luziato/soccer-18-19/elettronica/dxf/Phoenix.dxf

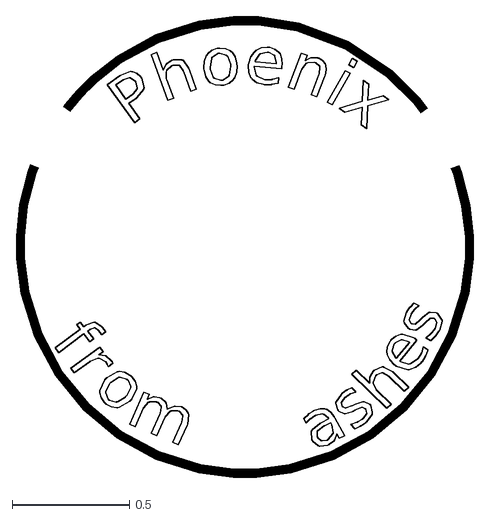
[picture p1: CAD file, 2019-02-13]
elettronica/dxf/Phoenix.dxf
1.95 x 1.97
