luziato/soccer-18-19/elettronica/immagini/vector/Phoenix.dxf

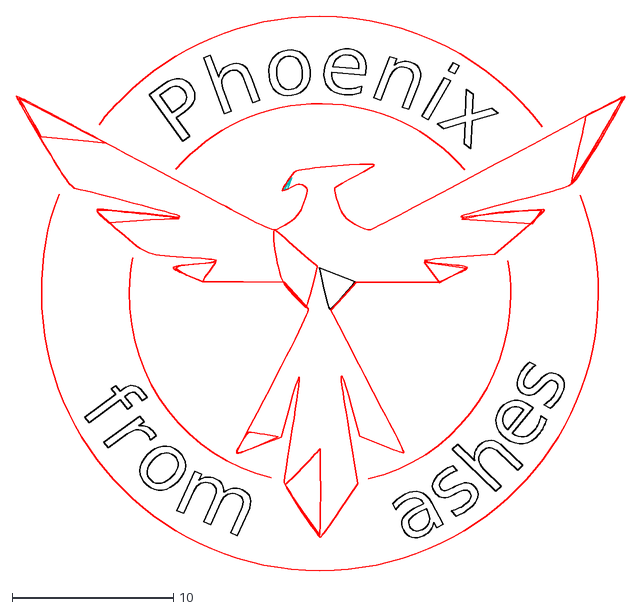
[picture p2: CAD file, 2019-02-13]
elettronica/immagini/vector/Phoenix.dxf
37.9 x 34.4
