luziato/soccer-18-19/elettronica/dxf/line sensor.dxf

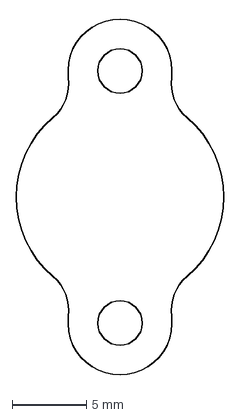
[picture p3: CAD file, 2019-02-13]
elettronica/dxf/line sensor.dxf
14.0 x 24.3 mm
