luziato/soccer-18-19/elettronica/testo.txt

da INSERIRE NELLO SCHEMATICO

-connettore per la batteria
-connettore per la pixi
-connettori pin femmina per circuito i4c
-swithc alimentazione
-swithc alimentazione motori
