luziato/soccer-18-19/elettronica/sensori di liena.brd

## EAGLE design elettronica/sensori di liena.brd (2019-02-13)

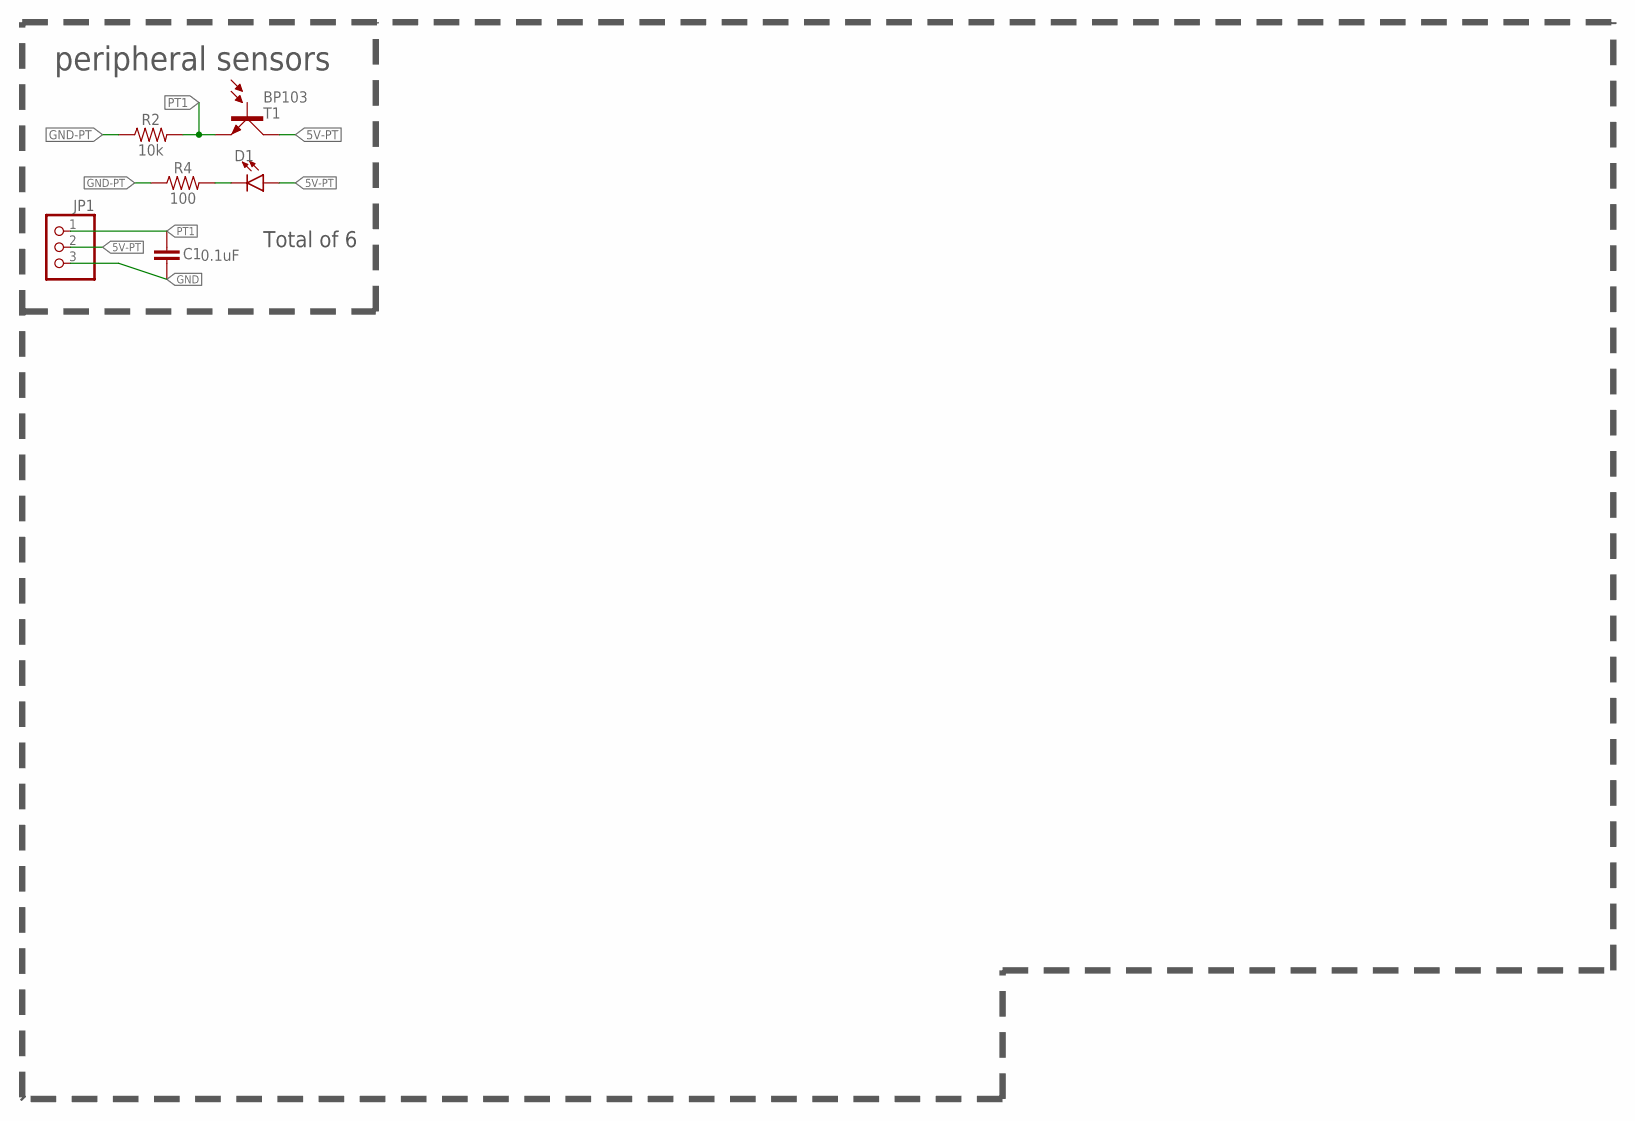
[picture p4: schematic sensori di liena.sch]

Parts:
C1: 0.1uF; CAP-PTH-SMALL-KIT
D1: LED3MM; LED_3MM
JP1: PINHD-1X3; 1X03
R2: 10k; 0603
R4: 100; 0603
T1: BP103

Connections:
5V-PT: D1.A, JP1.2, T1.C
GND: C1.2, JP1.3
GND-PT: R2.1, R4.1
unnamed: D1.K (C), R4.2
PT1: C1.1, JP1.1, R2.2, T1.E

Notes on the sheet:
peripheral sensors
Total of 6

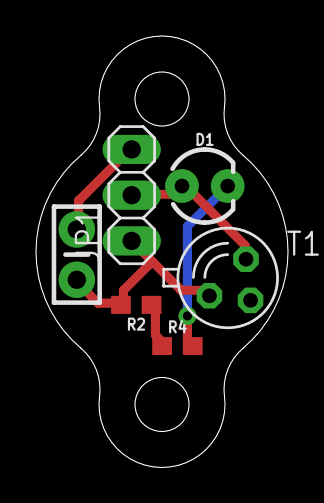
[picture p5: board sensori di liena.brd from above]

Board: 2 copper layers, 14.0 x 24.0 mm, 6 parts (0 on the bottom side), 5 nets.
