luziato/soccer-18-19/elettronica/main.brd

## EAGLE design elettronica/main.brd (2019-02-13)

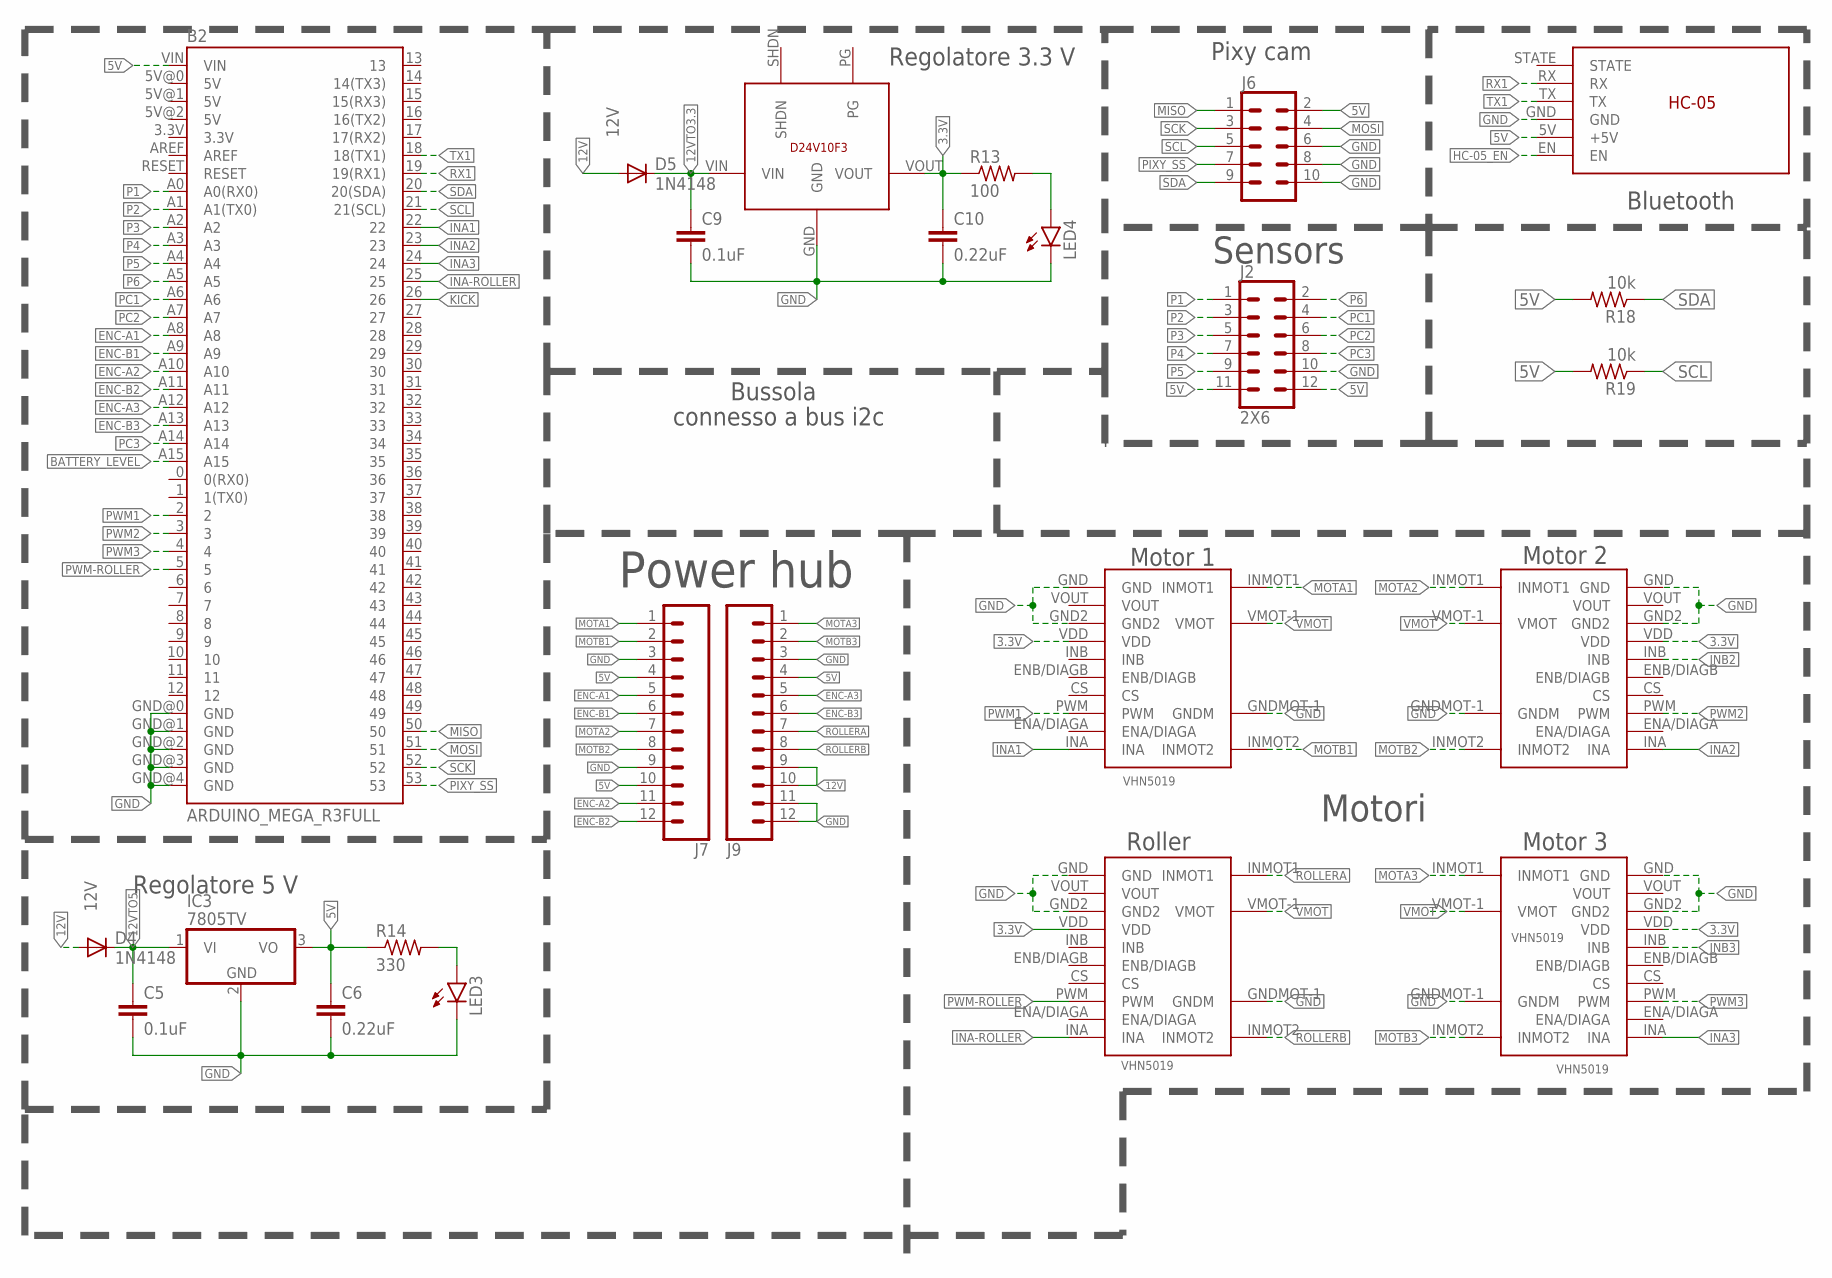
[picture p6: schematic main.sch, sheet 1]

Parts:
B2: ARDUINO_MEGA_R3FULL; ARDUINO_MEGA
C5, C9: 0.1uF; CAP-PTH-SMALL-KIT
C6, C10: 0.22uF; CAP-PTH-SMALL-KIT
D4, D5: 1N4148; DO35-7
IC3: 7805TV; TO220V
J2: 2X6
J6: CONN_05X2PTH; 2X5
J7, J9: CONN_12; 1X12
LED3, LED4: GREEN; LED-1206
R13: 100; M1206
R14: 330; M1206
R18, R19: 10k; M1206
U$4, U$5, U$6, U$7: VHN5019; MOTOR-SHIELD
U$18: HC-05
U$19: STEPDOWN_D24V10F3

Connections:
3.3V: C10.1, R13.1, U$4.VDD, U$5.VDD, U$6.VDD, U$7.VDD, U$19.VOUT; also elsewhere on the board
5V: B2.VIN, C6.1, IC3.3 (VO), J2.11, J2.12, J6.2, J7.4, J7.10, J9.4, R14.1, R18.2, R19.2, U$18.5V (+5V); also elsewhere on the board
12V: D4.A, D5.A, J9.9, J9.10; also elsewhere on the board
12VTO3.3: C9.1, D5.C, U$19.VIN
12VTO5: C5.1, D4.C, IC3.1 (VI)
BATTERY_LEVEL: B2.A15; also elsewhere on the board
ENC-A1: B2.A8, J7.5
ENC-A2: B2.A10, J7.11
ENC-A3: B2.A12, J9.5
ENC-B1: B2.A9, J7.6
ENC-B2: B2.A11, J7.12
ENC-B3: B2.A13, J9.6
GND: B2.GND@0 (GND), B2.GND@1 (GND), B2.GND@2 (GND), B2.GND@3 (GND), B2.GND@4 (GND), C5.2, C6.2, C9.2, C10.2, IC3.2 (GND), J2.10, J6.6, J6.8, J6.10, J7.3, J7.9, J9.3, J9.11, J9.12, LED3.C, LED4.C, U$4.GND, U$4.GND2, U$4.GNDMOT-1 (GNDM), U$5.GND, U$5.GND2, U$5.GNDMOT-1 (GNDM), U$6.GND, U$6.GND2, U$6.GNDMOT-1 (GNDM), U$7.GND, U$7.GND2, U$7.GNDMOT-1 (GNDM), U$18.GND, U$19.GND; also elsewhere on the board
HC-05_EN: U$18.EN
INA1: B2.22, U$4.INA
INA2: B2.23, U$5.INA
INA3: B2.24, U$6.INA
INA-ROLLER: B2.25, U$7.INA
INB2: U$5.INB
INB3: U$6.INB
KICK: B2.26; also elsewhere on the board
MISO: B2.50, J6.1
MOSI: B2.51, J6.4
MOTA1: J7.1, U$4.INMOT1
MOTA2: J7.7, U$5.INMOT1
MOTA3: J9.1, U$6.INMOT1
MOTB1: J7.2, U$4.INMOT2
MOTB2: J7.8, U$5.INMOT2
MOTB3: J9.2, U$6.INMOT2
unnamed: LED3.A, R14.2
unnamed: LED4.A, R13.2
P1: B2.A0 (A0(RX0)), J2.1
P2: B2.A1 (A1(TX0)), J2.3
P3: B2.A2, J2.5
P4: B2.A3, J2.7
P5: B2.A4, J2.9
P6: B2.A5, J2.2
PC1: B2.A6, J2.4
PC2: B2.A7, J2.6
PC3: B2.A14, J2.8
PIXY_SS: B2.53, J6.7
PWM1: B2.2, U$4.PWM
PWM2: B2.3, U$5.PWM
PWM3: B2.4, U$6.PWM
PWM-ROLLER: B2.5, U$7.PWM
ROLLERA: J9.7, U$7.INMOT1
ROLLERB: J9.8, U$7.INMOT2
RX1: B2.19 (19(RX1)), U$18.RX
SCK: B2.52, J6.3
SCL: B2.21 (21(SCL)), J6.5, R19.1; also elsewhere on the board
SDA: B2.20 (20(SDA)), J6.9, R18.1; also elsewhere on the board
TX1: B2.18 (18(TX1)), U$18.TX
VMOT: U$4.VMOT-1 (VMOT), U$5.VMOT-1 (VMOT), U$6.VMOT-1 (VMOT), U$7.VMOT-1 (VMOT); also elsewhere on the board

Notes on the sheet:
Regolatore 5 V
Regolatore 3.3 V
Bluetooth
Bussola
Motori
Roller
Motor 1
Motor 2
Motor 3
Pixy cam
Sensors
Power hub
connesso a bus i2c

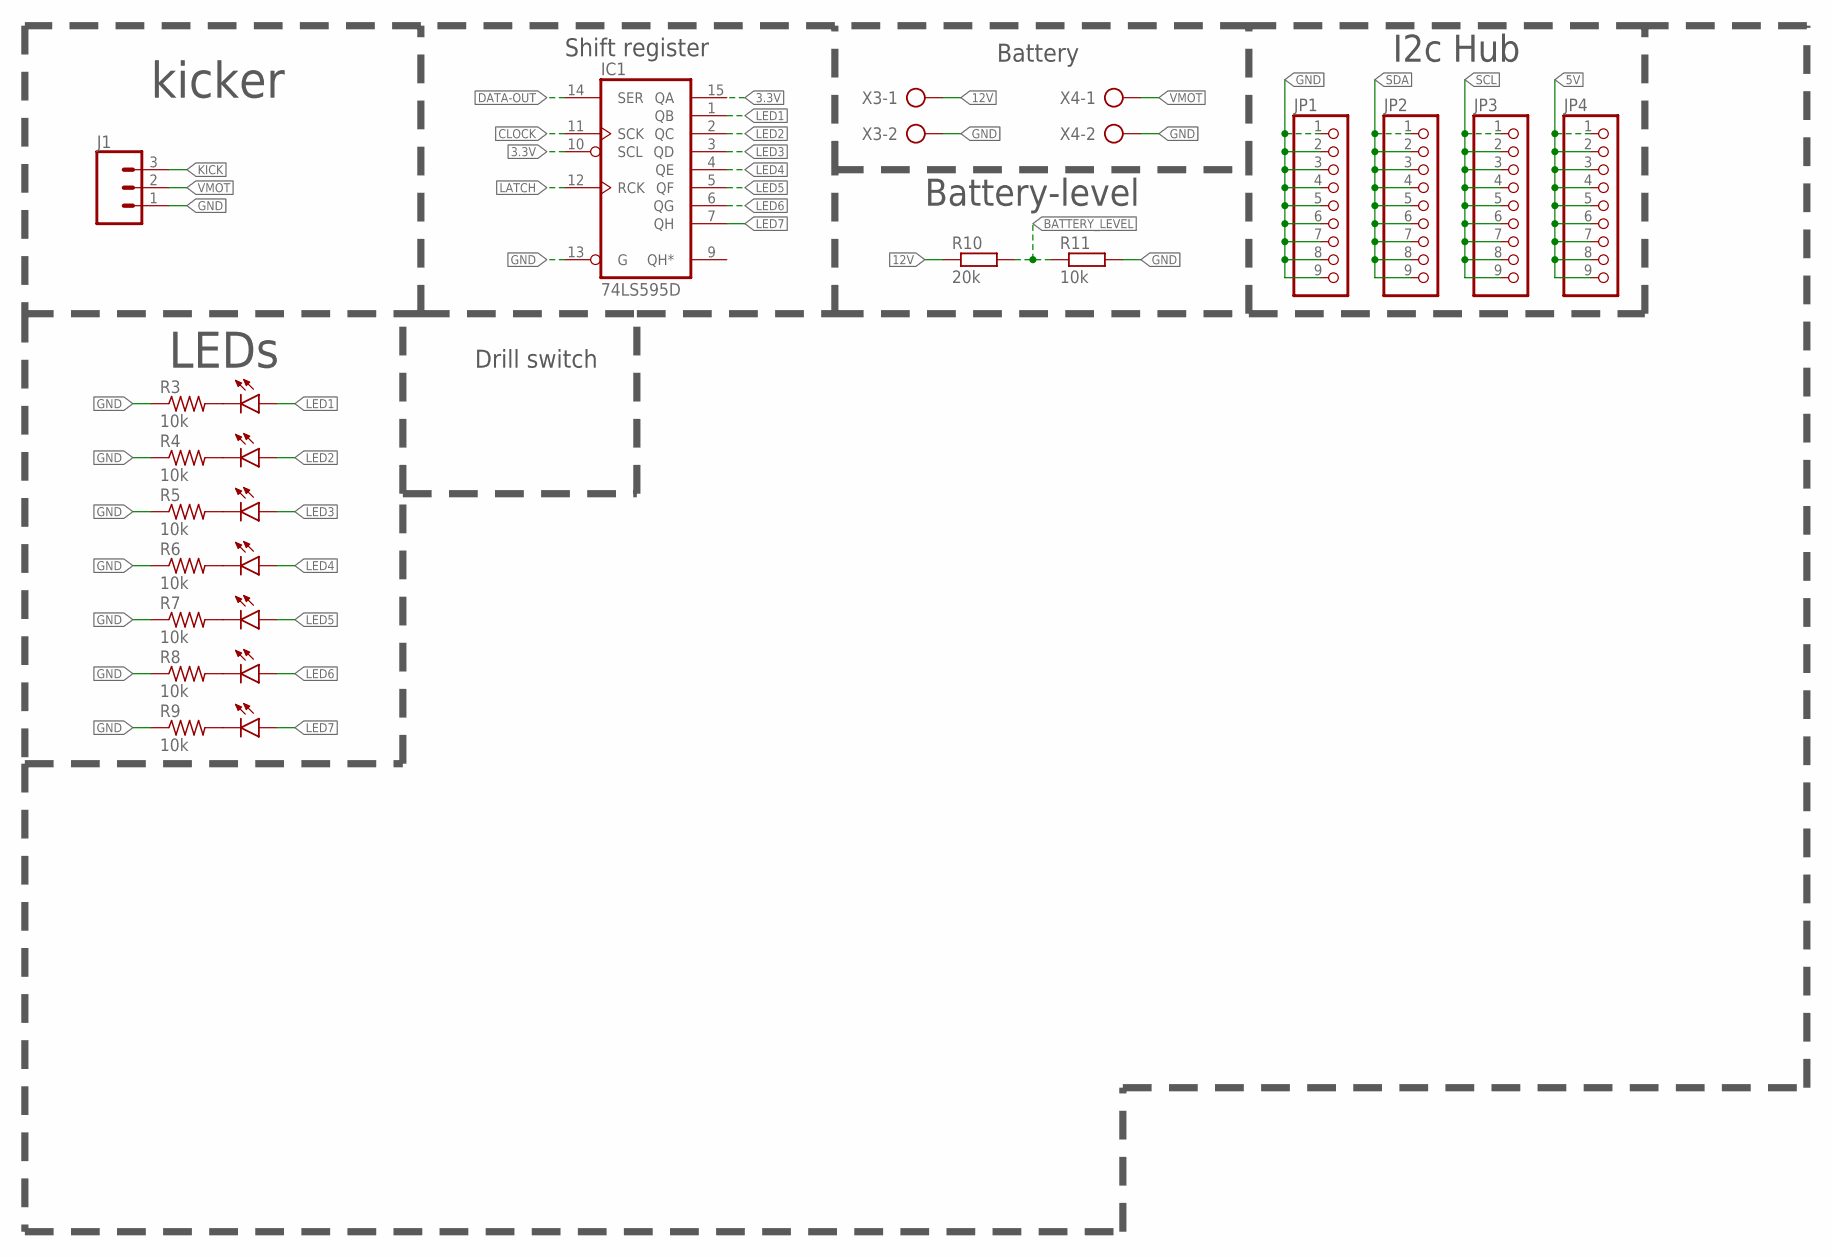
[picture p7: schematic main.sch, sheet 2]

Parts:
D1, D3, D6, D7, D8, D9, D10: GREEN; LED-1206
IC1: 74LS595D; SO16
J1: CONN_03; 1X03
JP1, JP2, JP3, JP4: PINHD-1X9; 1X09-BIG
R3, R4, R5, R6, R7, R8, R9: 10k; M1206
R10: 20k; 0204/7
R11: 10k; 0204/7
X3, X4: AK500/2-H

Connections:
3.3V: IC1.10 (SCL), IC1.15 (QA); also elsewhere on the board
5V: JP4.1, JP4.2, JP4.3, JP4.4, JP4.5, JP4.6, JP4.7, JP4.8, JP4.9; also elsewhere on the board
12V: R10.1, X3.1; also elsewhere on the board
BATTERY_LEVEL: R10.2, R11.1; also elsewhere on the board
CLOCK: IC1.11 (SCK)
DATA-OUT: IC1.14 (SER)
GND: IC1.8 (GND), IC1.13 (G), J1.1, JP1.1, JP1.2, JP1.3, JP1.4, JP1.5, JP1.6, JP1.7, JP1.8, JP1.9, R3.1, R4.1, R5.1, R6.1, R7.1, R8.1, R9.1, R11.2, X3.2, X4.2; also elsewhere on the board
KICK: J1.3; also elsewhere on the board
LATCH: IC1.12 (RCK)
LED1: D1.A, IC1.1 (QB)
LED2: D3.A, IC1.2 (QC)
LED3: D6.A, IC1.3 (QD)
LED4: D7.A, IC1.4 (QE)
LED5: D8.A, IC1.5 (QF)
LED6: D9.A, IC1.6 (QG)
LED7: D10.A, IC1.7 (QH)
unnamed: D1.C, R3.2
unnamed: D3.C, R4.2
unnamed: D6.C, R5.2
unnamed: D7.C, R6.2
unnamed: D8.C, R7.2
unnamed: D9.C, R8.2
unnamed: D10.C, R9.2
SCL: JP3.1, JP3.2, JP3.3, JP3.4, JP3.5, JP3.6, JP3.7, JP3.8, JP3.9; also elsewhere on the board
SDA: JP2.1, JP2.2, JP2.3, JP2.4, JP2.5, JP2.6, JP2.7, JP2.8, JP2.9; also elsewhere on the board
VCC: IC1.16 (VCC)
VMOT: J1.2, X4.1; also elsewhere on the board

Notes on the sheet:
Shift register
Battery
LEDs
Battery-level
Drill switch
I2c Hub
kicker

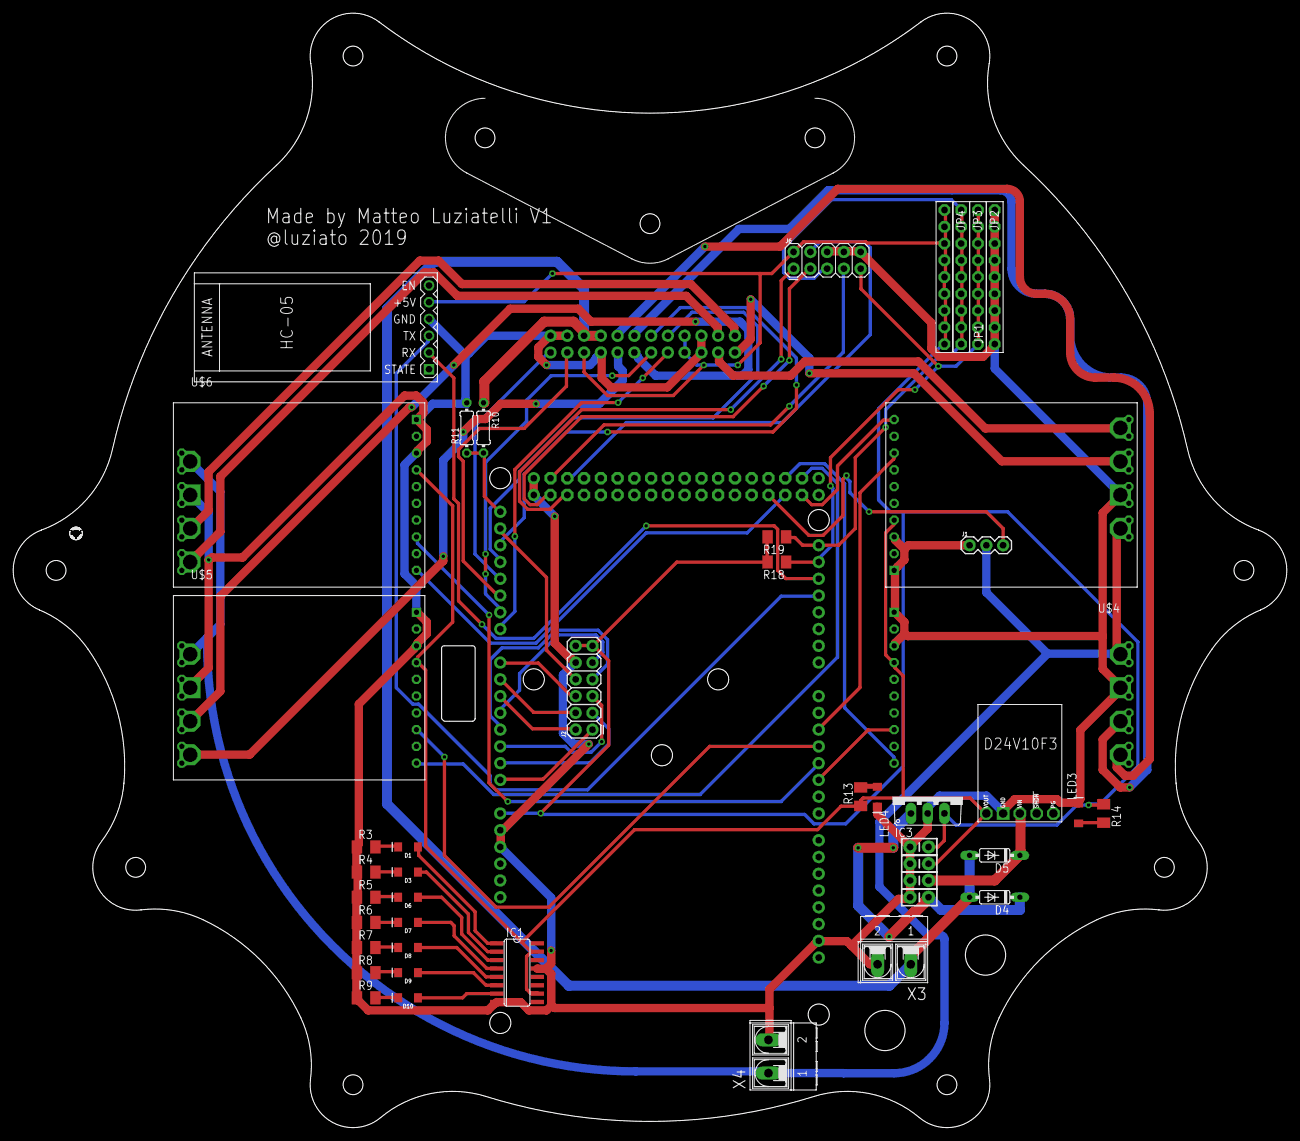
[picture p8: board main.brd from above]

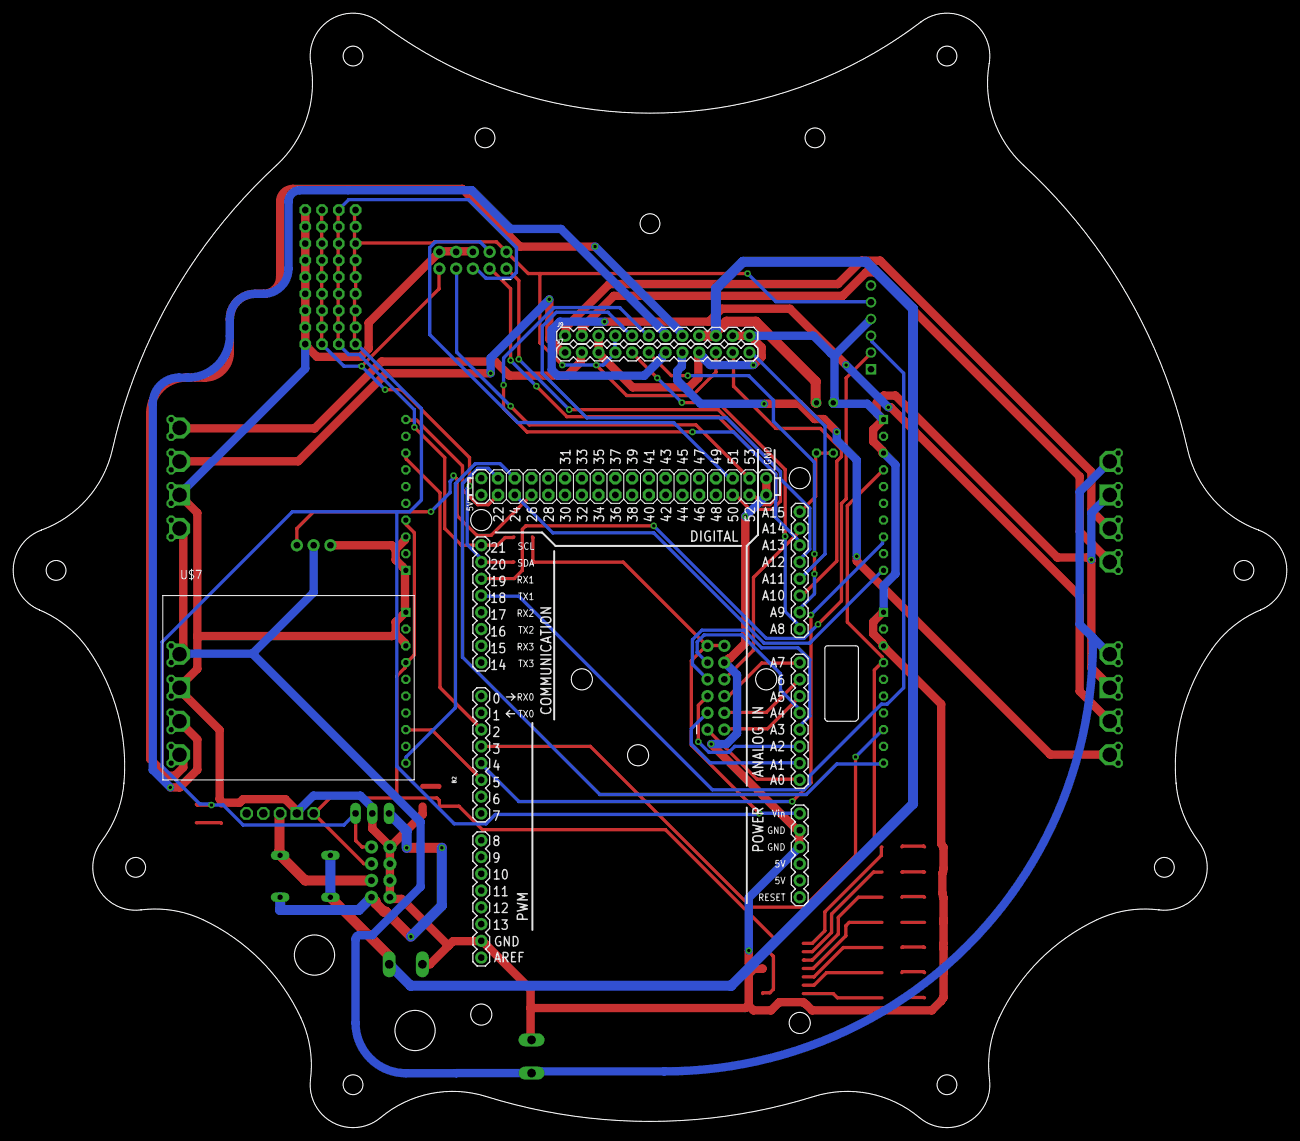
[picture p9: board main.brd from below]

Board: 2 copper layers, 193.0 x 168.9 mm, 48 parts (4 on the bottom side), 64 nets.
