luziato/soccer-18-19/elettronica/solenoid.brd

## EAGLE design elettronica/solenoid.brd (2019-02-13)

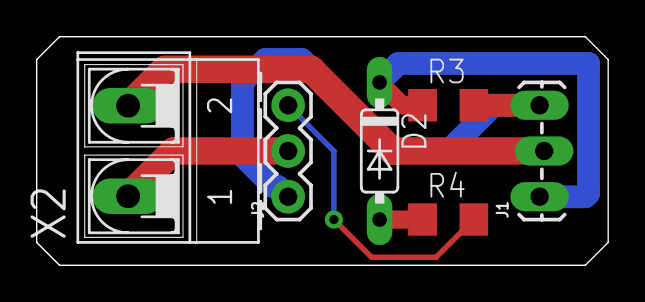
[picture p10: board solenoid.brd from above]

Board: 2 copper layers, 31.8 x 12.7 mm, 6 parts (0 on the bottom side), 6 nets.

Parts:
D2: 1N4148; DO35-7
J1: stp16nf06; 1X03_LOCK_LONGPADS
J2: 1X03
R3: 10k; R1206
R4: 100; R1206
X2: AK500/2-H

Connections:
12V: J2.2, X2.1
DRAIN: J1.2, X2.2
GND: J1.3, J2.1, R3.2
KICK: J2.3, R4.2
unnamed: D2.C, J1.1, R3.1
unnamed: D2.A, R4.1
