luziato/soccer-18-19/(commit log)

2019-01-21 aggiunta la motor hub
    [main.brd, main.sch, schematico- matteo.brd, schematico- matteo.sch, sensori di liena.brd, sensori di liena.sch]
2019-01-22 posizionare i pezzi nella board
    aggiute anche ulp per autoposizionamento e drc sparkfun
    [main.sch]
2019-01-23 continuare a posizionare i pezzi nella board
    [main.brd, main.sch, sensori di liena.sch]
2019-01-31 PCB Finita
    posizionati tutti i componenti e tracciate tutte le piste
    [main.brd, main.sch]
2019-01-31 PCB DEFINITIVA
2019-02-05 sensori di linea done
    [line sensor.dxf, sensori di liena.brd, sensori di liena.sch, solenoid.sch]
2019-02-07 pcb definitiva 2.0
    [main.brd, main.sch, sensori di liena.brd, sensori di liena.sch, solenoid.brd]
2019-02-13 adding vector graphic
    [Phoenix.dxf, main.brd, sensori di liena.brd, solenoid.brd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]
2019-03-18 sistemati gli encoder
2019-03-29 yatili e steora funzionano
    mancano sensori di linea
    da migliorare pid
2019-03-31 Un po'di roba da provare e sistemare
    tra cui il PID e alcune funzioni in firmware
2019-04-02 mancano i sensori di linea
2019-04-02 primo giorno di gare un po' di modifiche soprattutto ai sensori di linea
2019-04-13 Trigger di Schmitt e contatore
